bendikhusa/frat-hw/hw/frat.kicad_pcb

## KiCad design hw/frat.kicad_pcb (2023-12-11)

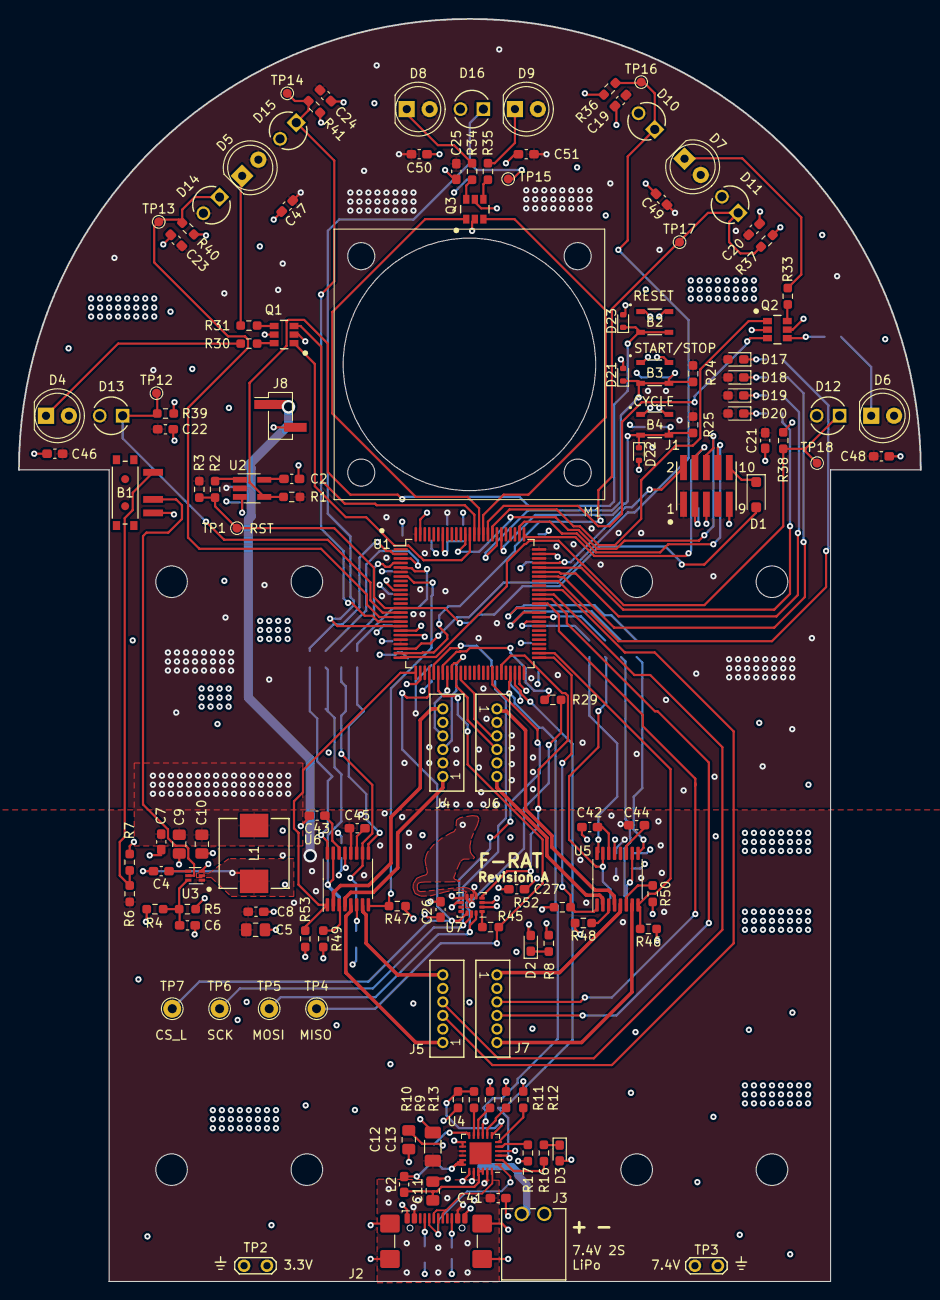
[picture p1: board frat.kicad_pcb from above]

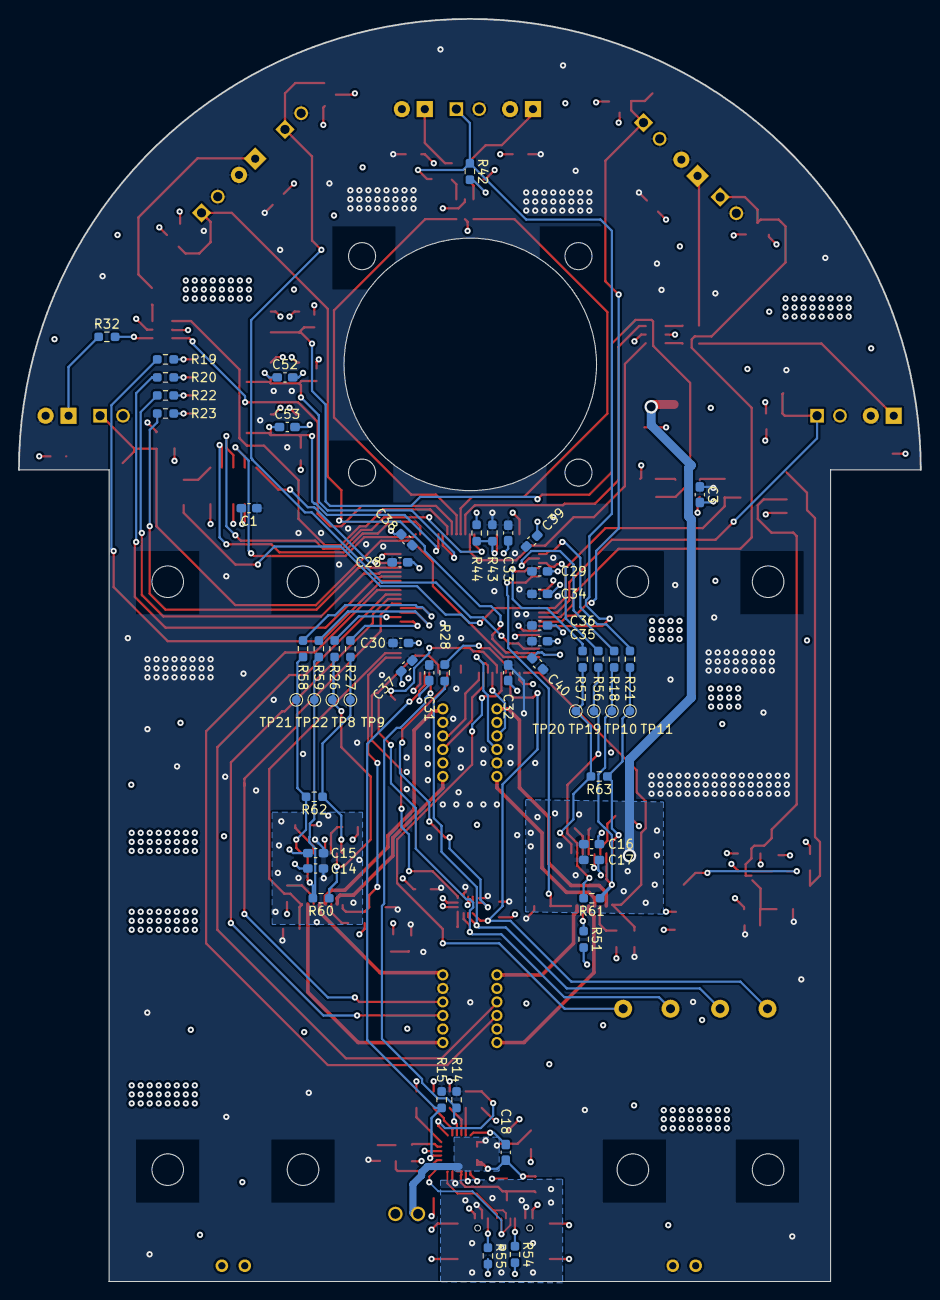
[picture p2: board frat.kicad_pcb from below]

Board: 4 copper layers, 100.0 x 140.0 mm, 188 parts (56 on the bottom side), 126 nets.

Parts:
B1: PCM12SMTR; PCM12SMTR_CNK
B2, B3, B4: PTS830GG140GSMTRLFS; PTS830GG140GSMTRLFS_CNK
C1, C2, C3, C4, C7, C8, C15, C17, C26, C27, C28, C29, C30, C31, C32, C33, C34, C35, C36, C41, C52, C53: 100 nF; C_0603_1608Metric_Pad1.08x0.95mm_HandSolder
C5, C9, C10, C11, C12: 10 uF; C_0805_2012Metric_Pad1.18x1.45mm_HandSolder
C6: 22 pF; C_0603_1608Metric_Pad1.08x0.95mm_HandSolder
C13: 47 uF; C_1206_3216Metric_Pad1.33x1.80mm_HandSolder
C14, C16, C37, C38, C39, C40: 10 uF; C_0603_1608Metric_Pad1.08x0.95mm_HandSolder
C18: 47 nF; C_0603_1608Metric_Pad1.08x0.95mm_HandSolder
C19, C20, C21, C22, C23, C24, C25, C42, C43: 2.2 uF; C_0603_1608Metric_Pad1.08x0.95mm_HandSolder
C44, C45: 10 nF; C_0603_1608Metric_Pad1.08x0.95mm_HandSolder
C46, C47, C48, C49, C50, C51: 4.7 uF; C_0603_1608Metric_Pad1.08x0.95mm_HandSolder
D1: PMEG2010AEH; D_SOD-123F
D2, D17, D18, D19, D20: HSMG-C190; LED_0603_1608Metric_Pad1.05x0.95mm_HandSolder
D3: HSMH-H190; LED_0603_1608Metric_Pad1.05x0.95mm_HandSolder
D4, D5, D6, D7, D8, D9: 950 nm, Vf = 1.5V typ; LED_D5.0mm_IRGrey
D10, D11, D12, D13, D14, D15, D16: LED_TEFT4300_VIS
D21, D22, D23: ESD5Z3.3T5G; D_SOD-523
J1: Conn_ARM_JTAG_SWD_10; CON10_2X5_DUK_FTSH_SAI
J2: USB_C_Receptacle_USB2.0; USB_C_Receptacle_GCT_USB4110
J3: 1778625; CONN_1814841
J4, J5, J6, J7: JST_B6B-ZR; CONN_B6B-ZR_JST
J8: Conn_01x02_Pin; PinHeader_1x02_P2.54mm_Vertical_SMD_Pin1Left
L1: 3.3 uH; IND_SRP7050_BRN
L2: 1 uH; L_0603_1608Metric_Pad1.05x0.95mm_HandSolder
M1: Fan; 30mm fan
M2, M3: N20 wheel assembly; N20
Q1, Q2, Q3: DMN2053UVT; TSOT-26-6
R1, R3, R5, R9, R10, R14, R15, R17, R24, R25, R43, R44, R46, R47, R52, R53: 10k; R_0603_1608Metric_Pad0.98x0.95mm_HandSolder
R2, R48, R49, R50, R51, R60, R61, R62, R63: 0; R_0603_1608Metric_Pad0.98x0.95mm_HandSolder
R4, R7: 30.9k; R_0603_1608Metric_Pad0.98x0.95mm_HandSolder
R6: 100k; R_0603_1608Metric_Pad0.98x0.95mm_HandSolder
R8, R19, R20, R22, R23: 300; R_0603_1608Metric_Pad0.98x0.95mm_HandSolder
R11: 330; R_0603_1608Metric_Pad0.98x0.95mm_HandSolder
R12: 150k; R_0603_1608Metric_Pad0.98x0.95mm_HandSolder
R13: 8.06k; R_0603_1608Metric_Pad0.98x0.95mm_HandSolder
R16: 430; R_0603_1608Metric_Pad0.98x0.95mm_HandSolder
R18, R21, R26, R27, R28, R29, R45, R56, R57, R58, R59: 33; R_0603_1608Metric_Pad0.98x0.95mm_HandSolder
R30, R31, R32, R33, R34, R35: 18; R_0603_1608Metric_Pad0.98x0.95mm_HandSolder
R36, R37, R38, R39, R40, R41, R42: 1.8k; R_0603_1608Metric_Pad0.98x0.95mm_HandSolder
R54, R55: 5.1k; R_0603_1608Metric_Pad0.98x0.95mm_HandSolder
TP1, TP8, TP9, TP10, TP11, TP12, TP13, TP14, TP15, TP16, TP17, TP18, TP19, TP20, TP21, TP22: TestPoint; TestPoint_Pad_D1.0mm
TP2, TP3: TestPoint_2Pole; TestPoint_2Pads_Pitch2.54mm_Drill0.8mm
TP4, TP5, TP6, TP7: TestPoint; TestPoint_THTPad_D2.0mm_Drill1.0mm
U1: STM32L562VET6; LQFP-100_14x14mm_P0.5mm
U2: TPS3840DL30DBV; SOT-23-5_HandSoldering
U3: TPS562202; SOT-563
U4: BQ25886RGET; VQFN-24-1EP_4x4mm_P0.5mm_EP2.45x2.45mm
U5, U6: DRV8833PW; TSSOP-16_4.4x5mm_P0.65mm
U7: LSM6DS3; LGA-14_3x2.5mm_P0.5mm_LayoutBorder3x4y

Connections:
+3.3V: C1.1, C3.1, C6.1, C7.1, C9.1, C10.1, C19.1, C20.1, C21.1, C22.1, C23.1, C24.1, C25.1, C26.1, C27.1, C28.1, C29.1, C30.1, C31.1, C32.1, C33.1, C34.1, C35.1, C36.1, C37.1, C38.1, C39.1, C40.1, C46.1, C47.1, C48.1, C49.1, C50.1, C51.1, D2.2, D3.2, D4.2, D5.2, D6.2, D7.2, D8.2, D9.2, D10.2 (A), D11.2 (A), D12.2 (A), D13.2 (A), D14.2 (A), D15.2 (A), D16.2 (A), D17.2, D18.2, D19.2, D20.2, J1.1 (VTref), J4.2 (VCC), J5.2 (VCC), J6.2 (VCC), J7.2 (VCC), L1.2, R1.1, R3.1, R4.1, R14.1, R15.1, R24.1, R25.1, R43.1, R46.1, R47.1, R52.1, R53.1, TP2.2, U1.6 (VBAT), U1.11 (VDD), U1.21 (VREF+), U1.22 (VDDA), U1.28 (VDD), U1.50 (VDD), U1.73 (VDDUSB), U1.75 (VDD), U1.100 (VDD), U2.2 (VDD), U7.5 (VDDIO), U7.8 (VDD)
+BATT: C5.1, C8.1, C13.1, C14.1, C15.1, C16.1, C17.1, C44.1, C45.1, J8.1, R6.2, TP3.2, U3.1 (VIN), U4.15 (SYS), U4.16 (SYS), U5.12 (VM), U6.12 (VM)
+BATT_DIRECT: C12.1, J3.1, U4.13 (BAT), U4.14 (BAT)
/Battery/CE_L: R15.2, U1.48 (PB11), U4.3 (~CE)
/Battery/PG_L: R14.2, U1.47 (PB10), U4.9 (~PG)
/Connectors/L1_MOTOR+: J6.6 (M1), U6.2 (AOUT1)
/Connectors/L1_MOTOR-: J6.1 (M2), U6.4 (AOUT2)
/Connectors/L1_MOTOR_C1: J6.4 (C1), U1.33 (PC4)
/Connectors/L1_MOTOR_C2: J6.3 (C2), U1.34 (PC5)
/Connectors/L2_MOTOR+: J7.6 (M1), U6.7 (BOUT1)
/Connectors/L2_MOTOR-: J7.1 (M2), U6.5 (BOUT2)
/Connectors/L2_MOTOR_C1: J7.4 (C1), U1.65 (PC8)
/Connectors/L2_MOTOR_C2: J7.3 (C2), U1.66 (PC9)
/Connectors/R1_MOTOR+: J4.6 (M1), U5.2 (AOUT1)
/Connectors/R1_MOTOR-: J4.1 (M2), U5.4 (AOUT2)
/Connectors/R1_MOTOR_C1: J4.4 (C1), U1.35 (PB0)
/Connectors/R1_MOTOR_C2: J4.3 (C2), U1.36 (PB1)
/Connectors/R2_MOTOR+: J5.6 (M1), U5.7 (BOUT1)
/Connectors/R2_MOTOR-: J5.1 (M2), U5.5 (BOUT2)
/Connectors/R2_MOTOR_C1: J5.4 (C1), U1.64 (PC7)
/Connectors/R2_MOTOR_C2: J5.3 (C2), U1.63 (PC6)
/MCU/BOOT_MODE: R43.2, R44.1, U1.94 (PH3/BOOT0)
/MCU/CYCLE_PROGRAM_BUTTON: B4.3 (A), B4.4 (C), C53.1, D22.1 (K), R25.2, U1.81 (PD0)
/MCU/LED0: R19.2, U1.68 (PA9)
/MCU/LED1: R20.2, U1.69 (PA10)
/MCU/LED2: R22.2, U1.70 (PA11)
/MCU/LED3: R23.2, U1.71 (PA12)
/MCU/LF_DETECTOR: D13.1 (K), R39.1, TP12.1, U1.15 (PC0)
/MCU/LF_EMITTER: Q1.1 (G2), U1.88 (PD7)
/MCU/L_DETECTOR1: D14.1 (K), R40.1, TP13.1, U1.16 (PC1)
/MCU/L_DETECTOR2: D15.1 (K), R41.1, TP14.1, U1.17 (PC2)
/MCU/L_EMITTER: Q1.3 (G2), U1.87 (PD6)
/MCU/L_MOTOR_FAULT_L: R47.2, U1.7 (PC13), U6.8 (nFAULT)
/MCU/L_MOTOR_SLEEP_L: R53.2, U1.26 (PA3), U6.1 (nSLEEP)
/MCU/MCU_RST_L: D1.2 (A), R2.2, R3.2, TP1.1, U1.14 (NRST)
/MCU/MCU_SWDCLK_TCK: J1.4 (SWDCLK/TCK), U1.76 (PA14/TCK/SWCLK)
/MCU/MCU_SWDIO_TMS: J1.2 (SWDIO/TMS), U1.72 (PA13/TMS/SWDIO)
/MCU/MCU_SWO_TDO: J1.6 (SWO/TDO), U1.89 (PB3/TDO/SWO)
/MCU/MCU_TDI: J1.8 (NC/TDI), U1.77 (PA15/TDI)
/MCU/MF_DETECTOR: D16.1 (K), R42.1, TP15.1, U1.18 (PC3)
/MCU/MF_EMITTER_1: Q3.1 (G2), U1.86 (PD5)
/MCU/MF_EMITTER_2: Q3.3 (G2), U1.85 (PD4)
/MCU/MOTOR_L_APWM1: R21.2, R63.1, TP11.1, U6.16 (AIN1)
/MCU/MOTOR_L_APWM2: R57.2, R63.2, TP20.1, U6.9 (BIN1)
/MCU/MOTOR_L_BPWM1: R18.2, R61.1, TP10.1, U6.15 (AIN2)
/MCU/MOTOR_L_BPWM2: R56.2, R61.2, TP19.1, U6.10 (BIN2)
/MCU/MOTOR_R_APWM1: R27.2, R62.1, TP9.1, U5.16 (AIN1)
/MCU/MOTOR_R_APWM2: R58.2, R62.2, TP21.1, U5.9 (BIN1)
/MCU/MOTOR_R_BPWM1: R26.2, R60.1, TP8.1, U5.15 (AIN2)
/MCU/MOTOR_R_BPWM2: R59.2, R60.2, TP22.1, U5.10 (BIN2)
/MCU/RF_DETECTOR: D12.1 (K), R38.1, TP18.1, U1.25 (PA2)
/MCU/RF_EMITTER: Q2.1 (G2), U1.83 (PD2)
/MCU/R_DETECTOR1: D11.1 (K), R37.1, TP17.1, U1.24 (PA1)
/MCU/R_DETECTOR2: D10.1 (K), R36.1, TP16.1, U1.23 (PA0)
/MCU/R_EMITTER: Q2.3 (G2), U1.84 (PD3)
/MCU/R_MOTOR_FAULT_L: R46.2, U1.52 (PB13), U5.8 (nFAULT)
/MCU/R_MOTOR_SLEEP_L: R52.2, U1.51 (PB12), U5.1 (nSLEEP)
/MCU/SPI_CS_L: TP7.1, U1.29 (PA4), U7.12 (CS)
/MCU/SPI_INT1: U1.45 (PE14), U7.4 (INT1)
/MCU/SPI_INT2: U1.43 (PE12), U7.9 (INT2)
/MCU/SPI_MISO: R45.1, TP4.1, U1.31 (PA6)
/MCU/SPI_MOSI: R29.2, TP5.1, U7.14 (SDA)
/MCU/SPI_SCK: R28.2, TP6.1, U7.13 (SCL)
/MCU/START_STOP_BUTTON: B3.3 (A), B3.4 (C), C52.1, D21.1 (K), R24.2, U1.82 (PD1)
/MCU/SWD_RST_L: D1.1 (K), J1.10 (~RESET)
/Power/DCDC_EN: B1.2 (B), U3.5 (EN)
/USB_D+: J2.A6 (D+), J2.B6 (D+), U4.24 (D+)
/USB_D-: J2.A7 (D-), J2.B7 (D-), U4.1 (D-)
GND: B1.3 (C), B2.1 (B), B2.2 (D), B3.1 (B), B3.2 (D), B4.1 (B), B4.2 (D), C1.2, C2.2, C3.2, C5.2, C7.2, C8.2, C9.2, C10.2, C11.2, C12.2, C13.2, C14.2, C15.2, C16.2, C17.2, C19.2, C20.2, C21.2, C22.2, C23.2, C24.2, C25.2, C26.2, C27.2, C28.2, C29.2, C30.2, C31.2, C32.2, C33.2, C34.2, C35.2, C36.2, C37.2, C38.2, C39.2, C40.2, C41.2, C42.2, C43.2, C46.2, C47.2, C48.2, C49.2, C50.2, C51.2, C52.2, C53.2, D21.2 (A), D22.2 (A), D23.2 (A), J1.3 (GND), J1.5 (GND), J1.9 (GNDDetect), J2.A1 (GND), J2.A12 (GND), J2.B1 (GND), J2.B12 (GND), J2.S1 (SHIELD), J3.2, J4.5 (GND), J5.5 (GND), J6.5 (GND), J7.5 (GND), J8.2, Q1.2 (S2), Q1.5 (S2), Q2.2 (S2), Q2.5 (S2), Q3.2 (S2), Q3.5 (S2), R5.2, R7.2, R8.2, R10.2, R11.2, R12.2, R13.2, R17.2, R36.2, R37.2, R38.2, R39.2, R40.2, R41.2, R42.2, R44.2, R48.2, R49.2, R50.2, R51.2, R54.2, R55.2, TP2.1, TP3.1, U1.10 (VSS), U1.19 (VSSA), U1.20 (VREF-), U1.27 (VSS), U1.49 (VSS), U1.74 (VSS), U1.99 (VSS), U2.3 (GND), U3.3 (GND), U4.4 (GND), U4.19 (GND), U4.20 (GND), U5.13 (GND), U6.13 (GND), U7.2 (SDX), U7.3 (SCX), U7.6 (GND), U7.7 (GND)
unnamed: B1.1 (A), R6.1, R7.1
unnamed: B2.3 (A), B2.4 (C), D23.1 (K), R1.2, U2.4 (~MR/NC)
unnamed: C11.1, L2.1, U4.21 (PMID), U4.22 (PMID)
unnamed: C18.1, L2.2, U4.17 (SW), U4.18 (SW)
unnamed: D2.1, R8.1
unnamed: D3.1, R16.1
unnamed: D4.1, R30.1
unnamed: D5.1, R31.1
unnamed: D6.1, R32.1
unnamed: D7.1, R33.1
unnamed: D8.1, R34.1
unnamed: D9.1, R35.1
unnamed: D17.1, R19.1
unnamed: D18.1, R20.1
unnamed: D19.1, R22.1
unnamed: D20.1, R23.1
unnamed: J2.A5 (CC1), R54.1
unnamed: J2.B5 (CC2), R55.1
unnamed: Q1.6 (D2), R30.2
unnamed: Q1.4 (D2), R31.2
unnamed: Q2.6 (D2), R33.2
unnamed: Q2.4 (D2), R32.2
unnamed: Q3.6 (D2), R34.2
unnamed: Q3.4 (D2), R35.2
unnamed: R28.1, U1.30 (PA5)
unnamed: R29.1, U1.32 (PA7)
unnamed: R27.1, U1.59 (PD12)
unnamed: R26.1, U1.60 (PD13)
unnamed: R59.1, U1.61 (PD14)
unnamed: R58.1, U1.62 (PD15)
unnamed: R21.1, U1.2 (PE3)
unnamed: R18.1, U1.3 (PE4)
unnamed: R56.1, U1.4 (PE5)
unnamed: R57.1, U1.5 (PE6)
unnamed: C2.1, U2.5 (CT)
unnamed: R2.1, U2.1 (~RESET)
unnamed: C4.1, U3.4 (BST)
unnamed: C6.2, R4.2, R5.1, U3.6 (FB)
unnamed: C4.2, L1.1, U3.2 (SW)
unnamed: C18.2, U4.12 (BTST)
unnamed: R13.1, U4.10 (ICHGSET)
unnamed: R11.1, U4.8 (ILIM)
unnamed: R17.1, U4.5 (OTG)
unnamed: R9.1, U4.11 (REGN)
unnamed: R16.2, U4.2 (STAT)
unnamed: R9.2, R10.1, U4.7 (TS)
unnamed: R12.1, U4.6 (VSET)
unnamed: R48.1, U5.3 (AISEN)
unnamed: R50.1, U5.6 (BISEN)
unnamed: C44.2, U5.11 (VCP)
unnamed: C42.1, U5.14 (VINT)
unnamed: R49.1, U6.3 (AISEN)
unnamed: R51.1, U6.6 (BISEN)
unnamed: C45.2, U6.11 (VCP)
unnamed: C43.1, U6.14 (VINT)
unnamed: R45.2, U7.1 (SDO/SA0)
VBUS: C41.1, J2.A4 (VBUS), J2.A9 (VBUS), J2.B4 (VBUS), J2.B9 (VBUS), U4.23 (VBUS)
