bendikhusa/frat-hw/(commit log)

2023-12-11 Added HW project - Added schematic files - Added PCB file - Added symbols and footprints - Added production files - Defined folder structure for mechanical files
    [battery.kicad_sch, connectors.kicad_sch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]
2023-12-11 Removed kicad generated files - Removed footprint and symbol lib table - Removed backup folder - Removed PRL file - Added kicad generated files to gitignore
2023-12-12 Add step files and Fusion 360 project for mechanical design
    [wheel.step, wheelassembly.step]
2023-12-12 Revert "Add step files and Fusion 360 project for mechanical design"
    This reverts commit e2e2db65c93b147c40e331ae3ebf91e184aca930.
    [wheel.step, wheelassembly.step]
2024-01-06 Fixed reference designators being wrong for hierarchical clones
    Moving PCB and schematic files to separate folders caused reference designators to become cloned for right and left motor drivers, revert this change
    [battery.kicad_sch, connectors.kicad_sch, frat.kicad_pcb, frat.kicad_sch, gyroscope.kicad_sch, mcu.kicad_sch, motor_control.kicad_sch, photodetectors.kicad_sch]
